raimundogabriel/projeto-bateria-gravitacional/logs/handoffs.md

FÍSICO  ──►  entrega: equações, constantes, restrições físicas
   │
   ▼
ARQUITETO ──►  entrega: mecânica + circuitos que atendem às restrições
   │
   ▼
DESENVOLVEDOR ──►  entrega: firmware + dashboard que leem/controlam
   │
   ▼
FÍSICO (volta) ──► valida: os dados medidos batem com o previsto?
