raimundogabriel/projeto-bateria-gravitacional/MVP_FABLAB/00_MASTER/QUESTOES_ABERTAS.md

# QUESTÕES ABERTAS — MVP FABLAB

Continua a numeração de `04_AUDITORIA/questoes_abertas.md` da raiz (até Q-008).

| ID | Pergunta | Por que importa | Quem decide | Status |
|----|---|---|---|---|
| Q-009 | Variante A (5 kg, 1,0 m, só LEDs, ≈ R$ 800) ou B (10 kg, 1,2 m, USB fraca para power bank, ≈ R$ 1.000)? | Define motor, altura da torre e a meta de geração (DEC-014) | Gabriel | ✅ respondida em 2026-10-29: nenhuma das duas; 6 kg de anilhas e 1,70 m, só LEDs (DEC-014, DEC-022) |
| Q-010 | Que máquinas e materiais o fablab tem (laser corta 15 mm? CNC router? impressora com PETG? sobras de perfil 2020)? | Define se base e topo saem no laser, na CNC ou na serra, e o custo real | Gabriel | aberta |
| Q-011 | O MVP é uma etapa antes do projeto principal (reaproveitando ESP32, IBT-2 etc.) ou o substitui? | Define se vale comprar peças do principal agora e se o relatório muda | Gabriel + grupo | aberta |
| Q-012 | Qual motorredutor comprar? | O resto do projeto depende de i, K_e e R_a (`01_FISICA/premissas.md`, "Se o motor mudar") | Gabriel (custo) | ✅ respondida em 2026-10-29: motor de 6 V, com 2 kg (DEC-024); depois trocado pela parafusadeira (DEC-026) |
| Q-013 | Qual é o modelo exato do motor de 6 V (redução ou rpm, torque, tipo de redutor, encoder)? | Confirma se retroaciona e se o tambor de Ø 30 mm serve (regra Ø ≈ redução / 3) | Gabriel | ✅ respondida em 2026-10-29: é o motor de 14,4 V da parafusadeira Bosch GSR 1440-LI (3 601 JA8 4..); o MVP usa a parafusadeira inteira (DEC-026) |
