raimundogabriel/projeto-bateria-gravitacional/MVP_FABLAB/02_ARQUITETO/mecanica.md

# MECÂNICA PARA FABLAB — MVP

Base: m_c = 5 kg, h = 1,00 m (DEC-014), cálculos em
`../01_FISICA/calculos_energia.md`. Nenhuma peça pede solda, torno ou
serralheria: tudo sai de corte a laser, impressão 3D, CNC router (opcional),
serra e furadeira.

## Arranjo
Mesmo princípio do projeto principal, em escala menor: duas colunas-guia, um
carrinho que corre entre elas, talha 2:1 (ponta fixa no topo, polia móvel no
carrinho, outra ponta no tambor) e o motorredutor no topo enrolando o cordão.
A catraca é parte da mesma peça impressa do tambor.

```mermaid
flowchart TB
    subgraph TOPO["Placa do topo (compensado 15 mm)"]
        M["Motorredutor 12 V Ø 37 mm 1:90<br/>com encoder Hall"] --- T["Tambor Ø 20 mm + catraca Ø 50 mm<br/>(uma peça PETG)"]
        T --- R["Mancal com rolamento 608"]
        L["Lingueta + mola<br/>puxada pelo servo MG90S"] -.trava.- T
        F["Ponta fixa do cordão"]
    end
    T -->|"cordão 2 mm"| P["Polia móvel Ø 30 mm<br/>no carrinho"]
    F -->|"cordão 2 mm"| P
    P --- C["Carrinho com 4 rodas V<br/>+ galão de 5 L"]
    C -.corre entre.- G["2 colunas de perfil 2020 × 1,50 m"]
    G --- B["Base de compensado 18 mm 400 × 500 mm<br/>com lastro ou presa à bancada"]
```

## Peças e processo

| Peça | Especificação | Processo |
|---|---|---|
| Colunas-guia | 2 × perfil de alumínio V-slot 20 × 20 × 1.500 mm | Serra; comprado cortado |
| Travessas | 2 × perfil 2020 × 260 mm (topo e meio), cantoneiras e porcas T M5 | Serra |
| Base | Compensado 18 mm, 400 × 500 mm | CNC router ou serra circular |
| Placa do topo | Compensado 15 mm, 300 × 150 mm, furos do motor, do mancal e da ponta fixa | CNC router ou laser (se cortar 15 mm) |
| Mãos-francesas | 4 triângulos de MDF 6 mm unindo colunas e base | Laser |
| Carrinho | Compensado 15 mm, 260 × 200 mm, 4 rodas V-slot com espaçador excêntrico, cinta com catraca para o galão | CNC ou serra + furadeira |
| Polia móvel | PETG, Ø 30 mm no fundo do canal, rolamento 608, eixo M8 | Impressão 3D |
| Tambor + catraca | PETG 100 % de preenchimento nos dentes, Ø 18 mm no fundo do canal helicoidal (passo 2,5 mm, 90 mm úteis), catraca Ø 50 mm com 24 dentes, furo D 6 mm com parafuso M3 e porca embutida, pino de aço Ø 8 mm na outra ponta | Impressão 3D |
| Mancal do tambor | Rolamento 608 num suporte impresso parafusado à placa do topo | Impressão 3D |
| Suporte do motor | Suporte em L para motor de 37 mm (vem com o motor ou impresso), 6 × M3 | Comprado ou impresso |
| Lingueta | PETG, pivô em parafuso M4, mola de tração pequena puxando para a catraca; o servo puxa por um elo de arame 1 mm | Impressão 3D |
| Suportes dos fins de curso | PETG, presos no canal do perfil com porca T: a posição se ajusta deslizando | Impressão 3D |
| Caixa da eletrônica | MDF 3 mm com tampa de acrílico 3 mm | Laser |
| Cordão | Dyneema ou poliéster trançado 2 mm, ruptura ≥ 100 kg, ~4 m | Comprado |
| Massa | Galão de água de 5 L cheio (ou saco de areia de 5 kg) | — |
| Batente | EVA 20 mm na base, sob o carrinho | Estilete |

## Por que estas escolhas
- **Perfil 2020 em vez de metalon:** é guia e estrutura ao mesmo tempo, as
  rodas V correm direto nele, e os fins de curso deslizam no canal. Muitos
  fablabs têm sobras de impressoras 3D e CNCs.
- **Tambor no eixo do motor com mancal do outro lado:** dispensa eixo de aço,
  mancais UCP e acoplamento. O mancal 608 tira do redutor a carga radial do
  cordão (24,5 N).
- **Talha 2:1 mantida:** divide o torque no tambor por dois (0,245 N·m) e
  dobra a rotação no gerador, que é o que dá tensão para os LEDs. Custa uma
  polia impressa e um rolamento.
- **Servo + mola no lugar do solenoide:** o servo de 5 V não precisa de
  MOSFET nem de hit-and-hold. A falha continua segura: sem energia no servo,
  a mola encosta a lingueta e a catraca segura a massa.

## Estrutura
- Carga no topo: 49 N com 5 kg, 98 N num tranco. Perfil 2020 em balanço de
  1,50 m com as mãos-francesas e a travessa do meio tem folga grande para
  isso; o que preocupa é tombar, não quebrar.
- Tombamento: centro de massa sobe até ~1,2 m (galão no alto). Base de 400 × 500 mm com
  ~5 kg de lastro (outro galão ou saco de areia) ou parafusada à bancada.

## Folgas obrigatórias
- **~1 cm acima do fim de curso superior.** A descida começa subindo 3 mm
  para aliviar a lingueta (mesma lógica da DEC-005 do projeto principal).
- Alturas: base 18 mm + batente 20 mm + carrinho com galão ~330 mm (polia
  no topo do carrinho) na posição inferior; 1.000 mm de curso; 10 mm de
  folga; da polia móvel ao topo da placa ~120 mm. Fecha em ~1.500 mm, a
  altura das colunas.
- O desenho cotado sai do ARQUITETO depois da escolha da variante (HANDOFF-010).

## Segurança
- Primeiros ciclos com o galão vazio, depois com 2,5 kg e corda de segurança.
- Ninguém com mão ou pé embaixo do carrinho; a área sob a torre fica livre.
- Conferir o cordão e o nó da ponta fixa antes de cada sessão.
