raimundogabriel/projeto-bateria-gravitacional/MVP_FABLAB/03_SOFTWARE/firmware/wokwi/sketch.ino

// Bateria gravitacional - MVP fablab - ESP32 (Wokwi e prototipo real)
//
// Mesma estrutura do firmware do projeto principal
// (03_SOFTWARE/firmware/wokwi/sketch.ino), adaptada ao MVP:
// 6 kg, 1,70 m, parafusadeira Bosch GSR 1440-LI inteira (motor 550 de 14,4 V
// + redutor ~1:42 na 1a marcha, sem a trava Auto-Lock, DEC-026) com o PWM
// limitado a 50 % da fonte de 12 V, cordao direto num tambor de 30 mm sem
// talha (DEC-025), encoder LPD3806 no eixo do tambor, sem reles (o IBT-2 com R_EN e L_EN separados faz a troca
// subir/gerar, DEC-017), trava por servo (DEC-019),
// 2x INA219 (DEC-018), hora por NTP e sem LCD (DEC-021), saida so com
// LEDs (DEC-022).
//
// Com SIMULACAO 1 (Wokwi), a massa e o gerador viram uma "planta virtual"
// calculada no codigo, o INA219 da subida vira um potenciometro e os LEDs de
// nivel do barramento gerado sao acesos pelo codigo.
//
// Comandos pelo Monitor Serial (115200):
//   a = automatico (fuzzy)   s = subir   d = descer   p = parar   r = rearme
//   h19 = forca a hora em 19 h (teste do fuzzy)   hx = volta a hora do NTP
//   w3 = demanda de 3 W vinda do painel (o painel manda pelo MQTT)
//
// Painel: o estado vai por MQTT a cada 1 s para <TOPICO_BASE>/estado e os
// comandos chegam por <TOPICO_BASE>/comando e <TOPICO_BASE>/tarifas
// (passo a passo em MVP_FABLAB/DIY/).

#define SIMULACAO 1

#include <Wire.h>
#include <WiFi.h>
#include <time.h>
#include <PubSubClient.h>
#if !SIMULACAO
#include <Adafruit_INA219.h>
#include <ESP32Encoder.h>
#endif

// ---------- pinos (iguais ao circuito real, MVP_FABLAB/03_SOFTWARE/pinagem_mvp.md) ----------
const uint8_t PIN_SERVO = 4;      // servo da lingueta (50 Hz)
const uint8_t PIN_L_EN = 13;      // BTS7960: meia-ponte do M-
const uint8_t PIN_RPWM = 16;      // BTS7960: subir
const uint8_t PIN_LPWM = 17;      // BTS7960: descer motorizado (so teste)
const uint8_t PIN_R_EN = 18;      // BTS7960: meia-ponte do M+
const uint8_t PIN_FRENAGEM = 19;  // MOSFET da carga de frenagem
const uint8_t PIN_FC_INF = 25;    // ALTO = acionado
const uint8_t PIN_FC_SUP = 26;    // ALTO = acionado
const uint8_t PIN_DEMANDA = 27;   // chave de demanda: BAIXO = ha demanda
const uint8_t PIN_ENC_A = 32;
const uint8_t PIN_ENC_B = 33;
const uint8_t PIN_EMERG = 34;     // ALTO = emergencia solta (12V_POT presente)
#if SIMULACAO
const uint8_t PIN_POT_CORRENTE = 35;  // no lugar do INA219 n. 1 (0 a 5 A)
const uint8_t PIN_LED_VERDE = 23;     // so Wokwi: no real os LEDs ficam direto no GEN
const uint8_t PIN_LED_AMARELO = 14;
const uint8_t PIN_LED_VERMELHO = 2;
#endif

// ---------- rede: hora por NTP (DEC-021) e painel por MQTT ----------
// No Wokwi: "Wokwi-GUEST", sem senha, e um broker publico. No fablab: a rede
// do fablab (ou o roteador do celular) e o IP do notebook que roda o
// Mosquitto e o painel (MVP_FABLAB/DIY/03_painel_mqtt.md).
const char *WIFI_SSID = "Wokwi-GUEST";
const char *WIFI_SENHA = "";
const char *MQTT_BROKER = "broker.hivemq.com";
const uint16_t MQTT_PORTA = 1883;
const char *TOPICO_BASE = "grav-mvp-fablab";  // broker publico: um nome so seu; Mosquitto do notebook: "grav"
const long FUSO_S = -3 * 3600;         // horario de Brasilia

// ---------- parametros do MVP (MVP_FABLAB/01_FISICA) ----------
const float MASSA = 6.0;           // kg de anilhas (DEC-026)
const float G = 9.81;
const float CURSO = 1.70;          // m, posicao do fim de curso superior
const float FOLGA_TOPO = 0.01;     // m de folga mecanica acima dele (alivio da trava)
const float V_SUBIDA = 0.10;       // m/s (C-108)
const float V_LIMITE = 0.30;       // m/s, acima disso e falha
const float V_ALVO_MIN = 0.10;     // m/s (C-107): LED verde
const float V_ALVO_MAX = 0.18;     // m/s: os 3 LEDs
const float KE_MASSA = 21.8;       // V por m/s de massa (Ke 0,0078 x 42 / 0,015), estimado ate o ensaio 0
const float V_GEN_MAX = 7.0;       // V (TVS de 8,2 V)
const float I_TRAVADO = 3.0;       // A medidos na fonte (C-108)
const float ALIVIO_TRAVA = 0.003;  // m que a massa sobe para soltar a lingueta
const float MM_POR_PULSO = 0.0393; // LPD3806 600 pulsos x4 no eixo do tambor de 30 mm, sem talha
const float DEMANDA_CHAVE = 5.0;   // W quando a chave de demanda esta ligada
const int PWM_MAX = 128;           // 50 % de 12 V: a subida nunca passa de ~0,23 m/s
const int PWM_SUBIDA = 68;         // ~27 %: 0,10 m/s (C-108)
const int PWM_ALIVIO = 35;         // ~14 %: sobe os 3 mm devagar
const float V_APROXIMA = 0.03;     // m/s nos ultimos 5 cm antes do topo
const int PWM_APROXIMA = 35;       // ~14 %: 0,03 m/s
const float K_SUBIDA = 300;        // ganho do PI da subida (PWM por m/s de erro)
const float K_DESCIDA = 0.6;       // ganho do PI da frenagem (por m/s de erro, a cada 50 ms)
const int SERVO_ENGATADA = 20;     // graus; calibrar no ensaio 3
const int SERVO_SOLTA = 80;        // graus
const unsigned long T_SERVO = 300; // ms para o servo puxar a lingueta

// Tarifa por posto horario (R$/kWh). Valores de exemplo ate o painel
// mandar os seus (topico <TOPICO_BASE>/tarifas, mensagem retida).
float tarifaFora = 0.60;
float tarifaInter = 0.90;
float tarifaPonta = 1.40;

// Potencia estimada nos 3 LEDs de nivel (220 ohm, acendem em ~2, 2,6 e 3,8 V)
const float LIMIAR_LED[] = {2.0, 2.6, 3.8};  // verde; amarelo + 1x 1N4148; vermelho + 3x 1N4148
const float R_LED = 220.0;
const float CONSUMO_AUX_W = 0.8;       // ESP32 com Wi-Fi, INA219 e servo parado

const unsigned long T_CONTROLE = 50;   // ms
const unsigned long T_FUZZY = 5000;    // ms
const unsigned long T_TELA = 1000;     // ms
const unsigned long T_MQTT = 1000;     // ms entre publicacoes do estado
const unsigned long T_RECONECTA = 10000; // ms entre tentativas de conectar no broker

#if SIMULACAO
// planta virtual (MVP_FABLAB/01_FISICA/calculos_energia.md)
const float V_MAX_SUBIDA = 0.229;    // m/s com PWM_MAX ((6 - 1,0) / 21,8)
const float QUEDA_RA = 1.0;          // V no enrolamento na subida (5 A x 0,2 ohm, C-108)
const float I_GEN = 0.70;            // A, imposta pelo torque da massa (C-109)
const float R_FIXA = 5.6;            // ohm, carga fixa sempre ligada
const float R_FRENAGEM = 2.2;        // ohm, chaveada pelo MOSFET
const float R_A = 0.2;               // ohm, enrolamento
const float ETA_SUBIDA = 0.37;       // cordao x redutor x motor, com I0 (C-103)
const float ETA_DESCIDA = 0.25;      // cordao x redutor x gerador (C-102)
#endif

enum Estado { MANTER, SUBINDO, PREP_DESCIDA, DESCENDO, PARANDO, FALHA, REARME };
const char *NOME_ESTADO[] = {"MANTER", "SUBINDO", "PREP_DESCIDA", "DESCENDO", "PARANDO", "FALHA", "REARME"};

// Os quatro modos do IBT-2 (MVP_FABLAB/02_ARQUITETO/circuito.md)
enum Ponte { LIVRE, SUBIR, GERAR, CURTO };
const char *NOME_PONTE[] = {"LIVRE", "SUBIR", "GERAR", "CURTO"};

enum Modo { AUTOMATICO, MANUAL };

Estado estado = REARME;
Modo modo = AUTOMATICO;
uint8_t etapa = 0;              // passo dentro de PREP_DESCIDA e REARME
unsigned long inicioEtapa = 0;
const char *motivoFalha = "";

float h = 0.40;                 // altura da massa (m), desconhecida no boot
float v = 0.0;                  // velocidade (m/s), positiva para cima
bool posicaoConhecida = false;

// atuadores
Ponte ponte = LIVRE;
bool travaLiberada = false;
int pwmMotor = 0;               // 0 a 255, so em SUBIR
float frenagem = 0.0;           // 0 a 1
float alvoDescida = V_ALVO_MIN; // m/s
float hInicioAlivio = 0.0;
int ticksTravado = 0;

// leituras
float corrente = 0, hora = 0, demanda = 0, tarifa = 0, vGen = 0;
float pSubida = 0, pGerada = 0, pLeds = 0, eSubida = 0, eGerada = 0, eLeds = 0, eAux = 0;
float horaForcada = -1, demandaPainel = 0;
bool horaValida = false;
float comandoFuzzy = 0;
long ciclos = 0;

long pulsos = 0;                // contagem do encoder (x4)

unsigned long ultControle = 0, ultFuzzy = 0, ultTela = 0, ultMqtt = 0, ultReconecta = 0;
bool publicarJa = false;        // troca de estado: publica sem esperar 1 s

WiFiClient rede;
PubSubClient mqtt(rede);
#if !SIMULACAO
Adafruit_INA219 inaSubida(0x40);
Adafruit_INA219 inaGerada(0x41);
ESP32Encoder encoder;
bool sensoresOk = false;
#endif

// =====================================================================
// PWM (LEDC), compativel com o core 2.x e 3.x do ESP32
// =====================================================================
void pwmIniciar(uint8_t pino, uint8_t canal, uint32_t freq, uint8_t bits = 8) {
#if ESP_ARDUINO_VERSION_MAJOR >= 3
  (void)canal;
  ledcAttach(pino, freq, bits);
#else
  ledcSetup(canal, freq, bits);
  ledcAttachPin(pino, canal);
#endif
}

void pwmEscrever(uint8_t pino, uint8_t canal, uint32_t duty) {
#if ESP_ARDUINO_VERSION_MAJOR >= 3
  (void)canal;
  ledcWrite(pino, duty);
#else
  (void)pino;
  ledcWrite(canal, duty);
#endif
}

const uint8_t CANAL_RPWM = 0, CANAL_LPWM = 1, CANAL_FRENAGEM = 2, CANAL_SERVO = 3;

// Servo a 50 Hz com 16 bits: 0 graus = 500 us, 180 graus = 2.500 us
void servoAngulo(int graus) {
  uint32_t us = 500 + (uint32_t)constrain(graus, 0, 180) * 2000 / 180;
  pwmEscrever(PIN_SERVO, CANAL_SERVO, us * 65535UL / 20000UL);
}

// =====================================================================
// Fuzzy (Mamdani, AND = min, OR = max, centroide) - igual ao principal
// =====================================================================
float trap(float x, float a, float b, float c, float d) {
  if (x >= b && x <= c) return 1.0;
  if (x < b) return (x <= a) ? 0.0 : (x - a) / (b - a);
  return (x >= d) ? 0.0 : (d - x) / (d - c);
}
float tri(float x, float a, float b, float c) { return trap(x, a, b, b, c); }

float saidaDescer(float y)  { return trap(y, -100, -100, -80, -50); }
float saidaParcial(float y) { return tri(y, -70, -40, -10); }
float saidaManter(float y)  { return tri(y, -25, 0, 25); }
float saidaSubir(float y)   { return trap(y, 40, 70, 100, 100); }

float centroide(float aDescer, float aParcial, float aManter, float aSubir) {
  float soma = 0, somaPeso = 0;
  for (int y = -100; y <= 100; y += 2) {
    float mu = max(max(min(aDescer, saidaDescer(y)), min(aParcial, saidaParcial(y))),
                   max(min(aManter, saidaManter(y)), min(aSubir, saidaSubir(y))));
    soma += mu * y;
    somaPeso += mu;
  }
  return somaPeso > 0 ? soma / somaPeso : 0;
}

float maxSubir = 1, maxDescer = 1;  // normalizacao do centroide

float fuzzy(float tar, float nivel, float dem) {
  tar = constrain(tar, 0.0f, 2.0f);
  nivel = constrain(nivel, 0.0f, 100.0f);
  dem = constrain(dem, 0.0f, 10.0f);

  float tb = trap(tar, 0, 0, 0.6, 0.8);
  float tm = tri(tar, 0.6, 0.9, 1.2);
  float ta = trap(tar, 0.9, 1.2, 2, 2);
  float nb = trap(nivel, 0, 0, 20, 45);
  float nm = tri(nivel, 20, 50, 95);
  float na = trap(nivel, 60, 95, 100, 100);
  float db = trap(dem, 0, 0, 0.3, 1);
  float dm = tri(dem, 0.3, 1.5, 3);
  float da = trap(dem, 2, 4, 10, 10);

  float aSubir = 0, aManter = 0, aParcial = 0, aDescer = 0;
  aSubir = max(aSubir, min(tb, nb));                       // R1
  aSubir = max(aSubir, min(tb, nm));                       // R2
  aManter = max(aManter, min(tb, na));                     // R3
  aManter = max(aManter, min(tm, nb));                     // R4
  aManter = max(aManter, min(tm, nm));                     // R5
  aParcial = max(aParcial, min(min(tm, na), da));          // R6
  aManter = max(aManter, min(min(tm, na), max(db, dm)));   // R7
  aManter = max(aManter, min(ta, nb));                     // R8
  aParcial = max(aParcial, min(min(ta, nm), max(dm, da))); // R9
  aDescer = max(aDescer, min(min(ta, na), max(dm, da)));   // R10
  aManter = max(aManter, min(ta, db));                     // R11

  float c = centroide(aDescer, aParcial, aManter, aSubir);
  return c >= 0 ? constrain(c / maxSubir * 100, 0.0f, 100.0f)
                : constrain(c / maxDescer * 100, -100.0f, 0.0f);
}

const char *postoDaHora(float hr) {
  if (hr >= 18 && hr < 21) return "ponta";
  if ((hr >= 17 && hr < 18) || (hr >= 21 && hr < 22)) return "intermediario";
  return "fora_ponta";
}

float tarifaDaHora(float hr) {
  const char *posto = postoDaHora(hr);
  if (posto[0] == 'p') return tarifaPonta;
  if (posto[0] == 'i') return tarifaInter;
  return tarifaFora;
}

// =====================================================================
// Atuadores: o unico lugar que mexe nos pinos do IBT-2 e do servo
// =====================================================================
void aplicarAtuadores() {
  bool rEn = ponte != LIVRE;
  bool lEn = ponte == SUBIR || ponte == CURTO;  // em GERAR o M- fica solto
  digitalWrite(PIN_R_EN, rEn ? HIGH : LOW);
  digitalWrite(PIN_L_EN, lEn ? HIGH : LOW);
  pwmMotor = constrain(pwmMotor, 0, PWM_MAX);   // nunca mais de 50 % (C-108)
  pwmEscrever(PIN_RPWM, CANAL_RPWM, ponte == SUBIR ? pwmMotor : 0);
  pwmEscrever(PIN_LPWM, CANAL_LPWM, 0);
  pwmEscrever(PIN_FRENAGEM, CANAL_FRENAGEM, (int)(frenagem * 255));
  servoAngulo(travaLiberada ? SERVO_SOLTA : SERVO_ENGATADA);
}

void estadoSeguro() {
  pwmMotor = 0;
  travaLiberada = false;
  frenagem = 1.0;
  ponte = CURTO;
}

void entrar(Estado novo) {
  if (estado == DESCENDO && novo != DESCENDO) ciclos++;
  estado = novo;
  etapa = 0;
  inicioEtapa = millis();
  publicarJa = true;
  Serial.print("-> ");
  Serial.println(NOME_ESTADO[novo]);
}

void falha(const char *motivo) {
  if (estado == FALHA) return;
  motivoFalha = motivo;
  estadoSeguro();
  entrar(FALHA);
  Serial.print("FALHA: ");
  Serial.println(motivo);
}

// =====================================================================
// Medicoes
// =====================================================================
#if SIMULACAO
// Planta virtual: substitui a massa, o gerador, o encoder e o INA219 n. 2
void atualizarPlanta(float dt) {
  bool energia = digitalRead(PIN_EMERG) == HIGH;  // sem 12V_POT: sem motor e sem servo
  bool travaSolta = travaLiberada && energia;     // sem 5V_SERVO a mola engata
  Ponte efetiva = energia ? ponte : LIVRE;        // sem B+ o IBT-2 nao conduz
  float vDesejada = 0;

  if (efetiva == SUBIR && pwmMotor > 0) {
    vDesejada = max(0.0f, (12.0f * pwmMotor / 255.0f - QUEDA_RA) / KE_MASSA);
  } else if (efetiva == CURTO) {
    vDesejada = 0;                                // motor em curto: quase parado
  } else if (travaSolta) {
    // Motor como gerador contra a carga fixa e a frenagem (C-109)
    float condutancia = 1.0f / R_FIXA + frenagem / R_FRENAGEM;
    vDesejada = -I_GEN * (1.0f / condutancia + R_A) / KE_MASSA;
  }

  v += (vDesejada - v) * 0.3;          // inercia
  if (v < 0 && !travaSolta) v = 0;     // a lingueta segura a descida
  h += v * dt;
  if (h < 0) { h = 0; if (v < 0) v = 0; }
  if (h > CURSO + FOLGA_TOPO) { h = CURSO + FOLGA_TOPO; if (v > 0) v = 0; }
  pulsos = lround(h * 1000.0 / MM_POR_PULSO);

  bool gerando = v < 0 && (efetiva == GERAR || efetiva == LIVRE);
  vGen = gerando ? -v * KE_MASSA : 0;
  pGerada = gerando ? MASSA * G * -v * ETA_DESCIDA : 0;
  pSubida = (efetiva == SUBIR && v > 0) ? MASSA * G * v / ETA_SUBIDA : 0;

  // LEDs de nivel do GEN (no real: diodos em serie + resistor, sem software)
  digitalWrite(PIN_LED_VERDE, vGen > LIMIAR_LED[0] ? HIGH : LOW);
  digitalWrite(PIN_LED_AMARELO, vGen > LIMIAR_LED[1] ? HIGH : LOW);
  digitalWrite(PIN_LED_VERMELHO, vGen > LIMIAR_LED[2] ? HIGH : LOW);
}

void lerSensores(float dt) {
  corrente = analogRead(PIN_POT_CORRENTE) * 5.0 / 4095.0;
  atualizarPlanta(dt);
}
#else
// Prototipo real: altura pelo encoder LPD3806 no eixo do tambor, contado pelo
// PCNT do ESP32 (ESP32Encoder, x4: o curso soma ~43.300 contagens), corrente e
// potencia de subida pelo INA219 0x40, tensao e potencia geradas pelo 0x41.
float hAnterior = 0;
void lerSensores(float dt) {
  pulsos = (long)encoder.getCount();
  h = pulsos * MM_POR_PULSO / 1000.0;
  v += ((h - hAnterior) / dt - v) * 0.5;   // filtro leve: o encoder anda aos saltos de 39 um
  hAnterior = h;
  if (!sensoresOk) return;
  corrente = max(inaSubida.getCurrent_mA(), 0.0f) / 1000.0;
  pSubida = max(inaSubida.getPower_mW(), 0.0f) / 1000.0;
  vGen = inaGerada.getBusVoltage_V();
  pGerada = max(inaGerada.getPower_mW(), 0.0f) / 1000.0;
}
#endif

// LEDs de nivel: cada um conduz (vGen - limiar) / R_LED a partir do seu limiar
float potenciaLeds(float vg) {
  float p = 0;
  for (float limiar : LIMIAR_LED) p += max(vg - limiar, 0.0f) / R_LED * vg;
  return p;
}

bool fimInferior() { return digitalRead(PIN_FC_INF) == HIGH || (SIMULACAO && h <= 0.0005); }
bool fimSuperior() { return digitalRead(PIN_FC_SUP) == HIGH || (SIMULACAO && h >= CURSO); }

// =====================================================================
// Maquina de estados (a cada 50 ms)
// =====================================================================
void zerarPosicao() {
  h = 0;
  pulsos = 0;
#if !SIMULACAO
  encoder.clearCount();
  hAnterior = 0;
#endif
  posicaoConhecida = true;
}

void controlar() {
  unsigned long agora = millis();
  unsigned long naEtapa = agora - inicioEtapa;

  // ---- protecoes ----
#if !SIMULACAO
  if (!sensoresOk) falha("INA219 nao encontrado");
#endif
  if (digitalRead(PIN_EMERG) == LOW) falha("emergencia");
  if (fabs(v) > V_LIMITE) falha("velocidade alta");
  if (vGen > V_GEN_MAX) falha("tensao gerada alta");
  if (estado == SUBINDO && corrente > I_TRAVADO) {
    if (++ticksTravado >= 10) falha("massa travada");
  } else {
    ticksTravado = 0;
  }

  switch (estado) {
    case MANTER:
      pwmMotor = 0;
      travaLiberada = false;
      ponte = LIVRE;
      if (naEtapa > 500) frenagem = 0;
      break;

    case SUBINDO:
      if (fimSuperior()) {
        entrar(PARANDO);
        break;
      }
      ponte = SUBIR;           // a catraca estala e deixa subir
      frenagem = 0;
      {
        // Desacelera nos ultimos 5 cm: a 0,10 m/s a massa passaria da folga do topo
        bool perto = h > CURSO - 0.05;
        int alvo = (perto ? PWM_APROXIMA : PWM_SUBIDA) + (int)(K_SUBIDA * ((perto ? V_APROXIMA : V_SUBIDA) - v));
        alvo = constrain(alvo, 0, PWM_MAX);
        pwmMotor += constrain(alvo - pwmMotor, -4, 4);  // rampa de ~1,1 s
      }
      break;

    case PREP_DESCIDA:
    case REARME:
      if (estado == REARME && etapa == 0 && fimInferior()) {
        zerarPosicao();
        estadoSeguro();
        entrar(PARANDO);
        break;
      }
      if (estado == PREP_DESCIDA && fimInferior()) {
        entrar(PARANDO);
        break;
      }
      if (etapa == 0) {        // sobe 3 mm para aliviar a lingueta
        ponte = SUBIR;
        frenagem = 0;
        hInicioAlivio = h;
        etapa = 1;
        inicioEtapa = agora;
      } else if (etapa == 1) {
        pwmMotor = PWM_ALIVIO;
        if (h >= hInicioAlivio + ALIVIO_TRAVA) {
          pwmMotor = 0;
          ponte = CURTO;       // o motor em curto segura enquanto o servo puxa
          travaLiberada = true;
          etapa = 2;
          inicioEtapa = agora;
        } else if (naEtapa > 3000) {
          falha("trava presa");
        }
      } else if (etapa == 2 && naEtapa >= T_SERVO) {
        frenagem = 1.0;        // freio maximo antes de soltar o M-
        ponte = GERAR;
        if (estado == PREP_DESCIDA) entrar(DESCENDO);
        else etapa = 3;        // rearme: desce com frenagem em 100 %
      } else if (etapa == 3) {
        frenagem = 1.0;
        if (fimInferior()) {
          zerarPosicao();
          entrar(PARANDO);
        }
      }
      break;

    case DESCENDO:
      if (fimInferior()) {
        entrar(PARANDO);
        break;
      }
      {
        // PI incremental: rapido demais -> mais frenagem
        float erro = -v - alvoDescida;
        frenagem = constrain(frenagem + K_DESCIDA * erro, 0.0f, 1.0f);
      }
      break;

    case PARANDO:
      pwmMotor = 0;
      frenagem = 1.0;
      ponte = CURTO;           // freio forte: a massa para em poucos ms
      travaLiberada = false;   // a mola leva a lingueta ao proximo dente
      if (naEtapa > 500) entrar(MANTER);
      break;

    case FALHA:
      estadoSeguro();
      break;
  }
}

// =====================================================================
// Decisao (a cada 5 s no automatico)
// =====================================================================
float nivel() { return constrain(h / CURSO * 100, 0.0f, 100.0f); }

void decidir() {
  comandoFuzzy = fuzzy(tarifa, nivel(), demanda);
  if (modo != AUTOMATICO || !posicaoConhecida || !horaValida) return;
  if (estado == FALHA || estado == REARME || estado == PREP_DESCIDA || estado == PARANDO) return;

  // Histerese: comeca com |comando| > 30 e continua enquanto |comando| > 10
  if (comandoFuzzy < -10) {
    alvoDescida = V_ALVO_MIN + max(-comandoFuzzy - 30, 0.0f) / 70.0f * (V_ALVO_MAX - V_ALVO_MIN);
  }
  if (estado == SUBINDO && comandoFuzzy <= 10) entrar(PARANDO);
  else if (estado == DESCENDO && comandoFuzzy >= -10) entrar(PARANDO);
  else if (estado == MANTER && comandoFuzzy > 30 && !fimSuperior()) entrar(SUBINDO);
  else if (estado == MANTER && comandoFuzzy < -30 && !fimInferior()) entrar(PREP_DESCIDA);
}

void executar(char c);

void lerComando() {
  if (!Serial.available()) return;
  String c = Serial.readStringUntil('\n');
  c.trim();
  if (c.length() == 0) return;

  if (c[0] == 'h') {
    if (c == "hx") horaForcada = -1;
    else horaForcada = constrain(c.substring(1).toFloat(), 0.0f, 23.99f);
    Serial.print("hora forcada: ");
    Serial.println(horaForcada);
    return;
  }
  if (c[0] == 'w') {
    demandaPainel = constrain(c.substring(1).toFloat(), 0.0f, 10.0f);
    Serial.print("demanda do painel: ");
    Serial.println(demandaPainel);
    return;
  }
  executar(c[0]);
}

// Comandos manuais, iguais pelo Monitor Serial e pelo painel
void executar(char c) {
  switch (c) {
    case 'a':
      modo = AUTOMATICO;
      Serial.println("modo automatico");
      break;
    case 's':
      modo = MANUAL;
      if (estado == MANTER && posicaoConhecida) entrar(SUBINDO);
      break;
    case 'd':
      modo = MANUAL;
      alvoDescida = V_ALVO_MAX;
      if (estado == MANTER && posicaoConhecida) entrar(PREP_DESCIDA);
      break;
    case 'p':
      modo = MANUAL;
      if (estado == SUBINDO || estado == DESCENDO || estado == PREP_DESCIDA) entrar(PARANDO);
      break;
    case 'r':
      if (estado == FALHA && digitalRead(PIN_EMERG) == HIGH) {
        posicaoConhecida = false;
        entrar(REARME);
      }
      break;
  }
}

// =====================================================================
// Hora (NTP) e Monitor Serial
// =====================================================================
void atualizarHora() {
  if (horaForcada >= 0) {
    hora = horaForcada;
    horaValida = true;
    return;
  }
  struct tm t;
  horaValida = getLocalTime(&t, 0);   // 0 ms: nao trava o loop esperando o NTP
  if (horaValida) hora = t.tm_hour + t.tm_min / 60.0;
}

void mostrar() {
  Serial.printf("%s %s ponte=%s h=%.3f nivel=%d%% v=%.3f fuzzy=%.0f hora=%s tarifa=%.2f dem=%.1fW "
                "gen=%.1fV freio=%d%% Psub=%.2fW Pgen=%.2fW Esub=%.1fJ Egen=%.1fJ ciclos=%ld I=%.2fA",
                NOME_ESTADO[estado], modo == AUTOMATICO ? "AUTO" : "MAN", NOME_PONTE[ponte],
                h, (int)nivel(), v, comandoFuzzy, horaValida ? String(hora, 2).c_str() : "--",
                tarifa, demanda, vGen, (int)(frenagem * 100), pSubida, pGerada, eSubida, eGerada,
                ciclos, corrente);
  if (estado == FALHA) Serial.printf(" motivo=%s (r = rearme)", motivoFalha);
  Serial.println();
}

// =====================================================================
// MQTT: estado para o painel, comandos e tarifas do painel
// =====================================================================
String topico(const char *nome) { return String(TOPICO_BASE) + "/" + nome; }

// Le um campo de um JSON plano, como {"acao":"subir","demanda_w":3}
bool campoJson(const String &json, const char *chave, String &valor) {
  int i = json.indexOf(String("\"") + chave + "\"");
  if (i < 0) return false;
  i = json.indexOf(':', i);
  if (i < 0) return false;
  i++;
  while (i < (int)json.length() && json[i] == ' ') i++;
  if (i < (int)json.length() && json[i] == '"') {
    int fim = json.indexOf('"', i + 1);
    if (fim < 0) return false;
    valor = json.substring(i + 1, fim);
  } else {
    int fim = i;
    while (fim < (int)json.length() && json[fim] != ',' && json[fim] != '}') fim++;
    valor = json.substring(i, fim);
    valor.trim();
  }
  return true;
}

void aoReceber(char *top, byte *dados, unsigned int n) {
  String json;
  for (unsigned int i = 0; i < n; i++) json += (char)dados[i];
  String t = top, valor;
  Serial.print("mqtt ");
  Serial.print(t);
  Serial.print(" ");
  Serial.println(json);

  if (t == topico("tarifas")) {
    if (campoJson(json, "fora_ponta", valor)) tarifaFora = constrain(valor.toFloat(), 0.0f, 2.0f);
    if (campoJson(json, "intermediario", valor)) tarifaInter = constrain(valor.toFloat(), 0.0f, 2.0f);
    if (campoJson(json, "ponta", valor)) tarifaPonta = constrain(valor.toFloat(), 0.0f, 2.0f);
    return;
  }
  if (t != topico("comando")) return;
  if (campoJson(json, "demanda_w", valor)) demandaPainel = constrain(valor.toFloat(), 0.0f, 10.0f);
  if (campoJson(json, "hora", valor)) {
    float hr = valor.toFloat();
    horaForcada = hr < 0 ? -1 : constrain(hr, 0.0f, 23.99f);
  }
  if (campoJson(json, "acao", valor)) {
    if (valor == "auto") executar('a');
    else if (valor == "subir") executar('s');
    else if (valor == "descer") executar('d');
    else if (valor == "parar") executar('p');
    else if (valor == "rearmar") executar('r');
  }
}

// Conecta no broker sem atrapalhar o controle: so tenta com a massa parada,
// porque a conexao pode travar o loop por alguns segundos se o broker sumir.
void manterMqtt(unsigned long agora) {
  if (mqtt.connected()) {
    mqtt.loop();
    return;
  }
  if (WiFi.status() != WL_CONNECTED) return;
  if (estado != MANTER && estado != FALHA) return;
  if (ultReconecta != 0 && agora - ultReconecta < T_RECONECTA) return;
  ultReconecta = agora;

  String id = "grav-esp32-" + String((uint32_t)ESP.getEfuseMac(), HEX);
  String online = topico("online");
  Serial.print("MQTT: conectando em ");
  Serial.println(MQTT_BROKER);
  if (mqtt.connect(id.c_str(), online.c_str(), 1, true, "0")) {
    mqtt.publish(online.c_str(), "1", true);
    mqtt.subscribe(topico("comando").c_str());
    mqtt.subscribe(topico("tarifas").c_str());
    Serial.println("MQTT: conectado");
    publicarJa = true;
  } else {
    Serial.print("MQTT: falhou, rc=");
    Serial.println(mqtt.state());
  }
}

void publicarEstado() {
  static char buf[700];
  snprintf(buf, sizeof(buf),
           "{\"estado\":\"%s\",\"modo\":\"%s\",\"ponte\":\"%s\",\"h_m\":%.3f,\"nivel_pct\":%.1f,"
           "\"v_ms\":%.3f,\"p_subida_w\":%.2f,\"p_gerada_w\":%.2f,\"p_leds_w\":%.3f,\"v_gen_v\":%.1f,"
           "\"frenagem_pct\":%d,\"tarifa_rs_kwh\":%.2f,\"posto\":\"%s\",\"demanda_w\":%.1f,"
           "\"comando\":%.1f,\"hora\":%.2f,\"hora_valida\":%s,\"ciclo\":%ld,\"e_subida_j\":%.1f,"
           "\"e_gerada_j\":%.1f,\"e_leds_j\":%.2f,\"e_aux_j\":%.0f,\"i_a\":%.2f,\"motivo\":\"%s\"}",
           NOME_ESTADO[estado], modo == AUTOMATICO ? "AUTOMATICO" : "MANUAL", NOME_PONTE[ponte],
           h, nivel(), v, pSubida, pGerada, pLeds, vGen, (int)(frenagem * 100), tarifa, postoDaHora(hora),
           demanda, comandoFuzzy, hora, horaValida ? "true" : "false", ciclos, eSubida, eGerada, eLeds,
           eAux, corrente, estado == FALHA ? motivoFalha : "");
  mqtt.publish(topico("estado").c_str(), buf);
}

// =====================================================================
void setup() {
  // EN em baixo antes de virar saida: ponte LIVRE no boot (pull-down 10 kOhm no real)
  for (uint8_t p : {PIN_R_EN, PIN_L_EN}) {
    digitalWrite(p, LOW);
    pinMode(p, OUTPUT);
  }
  pinMode(PIN_EMERG, INPUT);          // GPIO 34 nao tem pull-up interno
  pinMode(PIN_FC_INF, INPUT_PULLUP);
  pinMode(PIN_FC_SUP, INPUT_PULLUP);
  pinMode(PIN_DEMANDA, INPUT_PULLUP);
  pinMode(PIN_ENC_A, INPUT_PULLUP);
  pinMode(PIN_ENC_B, INPUT_PULLUP);
#if SIMULACAO
  for (uint8_t p : {PIN_LED_VERDE, PIN_LED_AMARELO, PIN_LED_VERMELHO}) pinMode(p, OUTPUT);
#else
  ESP32Encoder::useInternalWeakPullResistors = puType::up;
  encoder.attachFullQuad(PIN_ENC_A, PIN_ENC_B);
  encoder.clearCount();
#endif

  pwmIniciar(PIN_RPWM, CANAL_RPWM, 20000);
  pwmIniciar(PIN_LPWM, CANAL_LPWM, 20000);
  pwmIniciar(PIN_FRENAGEM, CANAL_FRENAGEM, 5000);
  pwmIniciar(PIN_SERVO, CANAL_SERVO, 50, 16);

  estadoSeguro();
  aplicarAtuadores();

  Serial.begin(115200);
  Wire.begin(21, 22);
#if !SIMULACAO
  sensoresOk = inaSubida.begin() && inaGerada.begin();
  // Os dois ficam na calibracao padrao (32 V, ate 3,2 A): a subida le a media
  // de ~1,3 A (o capacitor do B+ alisa o PWM) e o gerador ate ~1 A.
  if (!sensoresOk) {
    Serial.println("INA219 nao encontrado (0x40 e 0x41): confira SDA 21, SCL 22 e o jumper A0 do segundo");
  }
#endif
  WiFi.mode(WIFI_STA);
  WiFi.begin(WIFI_SSID, WIFI_SENHA);   // conecta em segundo plano
  configTime(FUSO_S, 0, "pool.ntp.org", "a.st1.ntp.br");
  mqtt.setServer(MQTT_BROKER, MQTT_PORTA);
  mqtt.setCallback(aoReceber);
  mqtt.setBufferSize(768);

  maxSubir = centroide(0, 0, 0, 1);
  maxDescer = -centroide(1, 0, 0, 0);

  Serial.println("Bateria gravitacional - MVP fablab - ESP32");
  Serial.print("MQTT: ");
  Serial.print(MQTT_BROKER);
  Serial.print(" topicos ");
  Serial.print(TOPICO_BASE);
  Serial.println("/estado, /comando, /tarifas");
  Serial.println("a=auto s=subir d=descer p=parar r=rearme h19=hora hx=hora do NTP w3=demanda do painel");
  entrar(REARME);  // posicao desconhecida: desce ate o fim de curso inferior
}

void loop() {
  unsigned long agora = millis();
  lerComando();

  if (agora - ultControle >= T_CONTROLE) {
    float dt = (agora - ultControle) / 1000.0;
    ultControle = agora;

    atualizarHora();
    tarifa = tarifaDaHora(hora);
    demanda = max(digitalRead(PIN_DEMANDA) == LOW ? DEMANDA_CHAVE : 0.0f, demandaPainel);

    lerSensores(dt);
    pLeds = potenciaLeds(vGen);
    eSubida += pSubida * dt;
    eGerada += pGerada * dt;
    eLeds += pLeds * dt;
    eAux += CONSUMO_AUX_W * dt;
    controlar();
    aplicarAtuadores();
  }

  manterMqtt(agora);
  if (mqtt.connected() && (publicarJa || agora - ultMqtt >= T_MQTT)) {
    ultMqtt = agora;
    publicarJa = false;
    publicarEstado();
  }

  if (agora - ultFuzzy >= T_FUZZY) {
    ultFuzzy = agora;
    decidir();
  }

  if (agora - ultTela >= T_TELA) {
    ultTela = agora;
    mostrar();
  }
}
