raimundogabriel/projeto-bateria-gravitacional/(commit log)

2026-10-08 (feat):Dashboard inicial
    [leituras_esp32.csv]
2026-10-28 (docs): consolida o projeto nos markdowns de cada persona
    Substitui os valores de exemplo do modelo (500 kg, 3 m, encoder no 34/35)
    pelas decisões reais: 20 kg, 1,70 m, motorredutor 24 V planetário 1:50 como
    motor e gerador, saída USB + LEDs, fuzzy de 3 entradas e eletrônica v2.
    - 00_MASTER: projeto, 12 decisões, estado atual, handoffs, glossário, skills
    - 01_FISICA: premissas, cálculos, algoritmos de controle, plano de ensaios
    - 02_ARQUITETO: dimensionamento, diagramas de blocos, esquema de potência
    - 03_SOFTWARE: pinagem, contrato MQTT grav/*, firmware Wokwi, nota no painel
    - 04_AUDITORIA: 32 inconsistências com status e 8 questões abertas
    - 05_DOC_ORIGINAL: relatório revisado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
2026-10-28 (feat): painel Streamlit da bateria gravitacional (DEC-013)
    Troca o mock de ventilador pelo painel da bateria, decidido em Streamlit:
    - src/fuzzy_bateria.py: fuzzy de 3 entradas e 11 regras, igual ao firmware
    (diferença máxima de 0,0001 numa grade de 2.646 combinações)
    - src/simulador.py: planta virtual de 20 kg e 1,70 m com a máquina de
    estados do firmware e dia de tarifas acelerado (20 min)
    - src/energia.py: energia por descida e economia simulada
    - abas Tempo Real, Histórico, Energia, Lógica Fuzzy, Controle e Relatório
    - remove scikit-fuzzy e o fuzzy/correlação do ventilador
    Registra DEC-013, fecha Q-001, HANDOFF-005 e INC-028, e troca Node-RED
    por Streamlit na seção 6 do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
2026-10-28 (docs): explica o esquema do Wokwi com diagramas Mermaid (ARQUITETO)
    - 02_ARQUITETO/circuitos/simulacao_wokwi.md: ligações do Wokwi, caminho de
    potência real que os LEDs representam, mapa pino a pino, diferenças entre
    Wokwi e protótipo e leitura das sequências nos LEDs
    - ESTADO_ATUAL: entrega e alerta da emergência só por software no Wokwi
    - HANDOFF-008: conferir os LEDs no Wokwi e fechar INC-031
    Claude-Session: https://claude.ai/code/session_01SiNrRJESPmsyquiXXFtpmB
2026-10-28 (docs): propõe releitura MVP para fablab em MVP_FABLAB/
    Variante menor (5 kg, 1,0 m, motorredutor 12 V 37 mm 1:90 com encoder,
    sem relés, servo na trava, 2x INA219, perfil 2020) organizada pelas
    personas. DEC-014 a DEC-021, HANDOFF-009 a 012 e Q-009 a 011 como
    propostas; o projeto principal só ganha ponteiros.
    Claude-Session: https://claude.ai/code/session_01SiNrRN3ZfAFHXcwKZV2Bfy
2026-10-28 (feat): firmware, projeto Wokwi e painel Streamlit do MVP fablab
    Firmware com a mesma estrutura do principal (estados, fuzzy, protecoes,
    SIMULACAO), adaptado ao MVP: 5 kg, 1,00 m, ponte do IBT-2 em 4 modos sem
    reles, servo na trava, hora por NTP, demanda por chave ou painel. Wokwi
    com servo, LEDs da ponte e do gerador. Painel copiado do principal com
    parametros do MVP e LEDs no lugar da USB (HANDOFF-011, HANDOFF-012).
    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
2026-10-29 (docs): MVP fablab com 6 kg de anilhas e 1,70 m, saida so com LEDs
    Porte decidido pelo Gabriel (DEC-014) e saida so com LEDs (DEC-022, a
    USB nao fecha com ~0,87 W). Refaz C-101 a C-109, torre de 2,05 m com o
    topo preso a parede, tambor de 150 mm, carga fixa de 100 ohm, BOM,
    firmware/Wokwi e painel. Motor segue como referencia (Q-012).
    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
2026-10-29 (feat): MQTT entre ESP32 e painel do MVP e passo a passo DIY
    - firmware: publica <base>/estado a cada 1 s e <base>/online, recebe
    <base>/comando (acao, demanda_w, hora) e <base>/tarifas; conecta no
    broker so com a massa parada; SIMULACAO 0 le os 2 INA219 e o encoder
    pelo PCNT (ESP32Encoder)
    - painel: fonte "ESP32 (MQTT)" (src/mqtt_esp32.py), configuracao do broker
    na barra lateral, comandos, demanda, hora e tarifas enviados de verdade
    - MVP_FABLAB/DIY/: gravar o ESP32, teste de bancada, Mosquitto e painel,
    problemas comuns
    - DEC-023; HANDOFF-013 com o andamento
    Claude-Session: https://claude.ai/code/session_01SiNrRN3ZfAFHXcwK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
2026-10-29 (docs): alimentacao e lista de compras da eletronica do MVP em DIY/
    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
2026-10-29 (docs): MVP com motor de 6 V e 2 kg, sem talha e tambor de 30 mm
    - FISICO: C-101 a C-109 refeitos (33 J por ciclo, ~9,9 J gerados,
    KE_MASSA 36, descida 0,06 a 0,13 m/s, limite 0,20 m/s)
    - ARQUITETO: cordao direto, tambor 30 mm; carga fixa 22 ohm, frenagem
    6,8 ohm, LEDs em 2 / 3,3 / 4,4 V, TVS 8,2 V; BOM atualizada
    - DESENVOLVEDOR: firmware com PWM limitado a 50 % (motor de 6 V na fonte
    de 12 V), desaceleracao nos ultimos 5 cm, novas constantes; planta
    virtual e painel atualizados, CSV de exemplo regenerado
    - DIY e lista de compras; DEC-024, DEC-025, Q-013
    Claude-Session: https://claude.ai/code/session_01SiNrRN3ZfAFHXcwKZV2Bfy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
2026-10-29 MVP_FABLAB: parafusadeira Bosch GSR 1440-LI inteira com 6 kg (DEC-026)
    O motor do grupo é o de 14,4 V da parafusadeira, não um motorredutor de
    6 V. O MVP passa a usar a parafusadeira inteira (redutor ~1:42 na 1ª
    marcha), sem gatilho e sem a trava Auto-Lock, com 6 kg no tambor de
    Ø 30 mm e encoder LPD3806 no eixo do tambor.
    - FÍSICO: premissas, C-101 a C-109 e ensaios refeitos (margem ~1,7×,
    KE_MASSA 21,8, subida 0,10 m/s ~270 J, descida ~25 J, η ~0,09)
    - ARQUITETO: preparo da parafusadeira, fonte 12 V 5 A, cargas 5,6 Ω e
    2,2 Ω 10 W, LEDs em 2 / 2,6 / 3,8 V, capacitor de 1.000 µF no B+
    - Firmware e painel com as novas constantes; INA219 nº 2 na calibração
    padrão; amostra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
